sdo9/talking-multimeter/board-pics/bottom.JPG

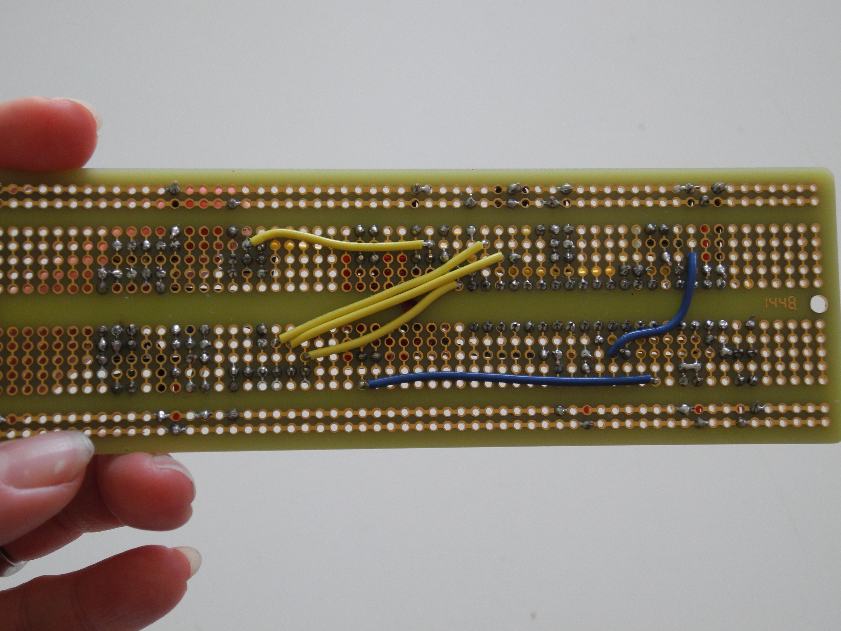
board-pics/bottom.JPG
