sdo9/talking-multimeter/board-pics/top.JPG

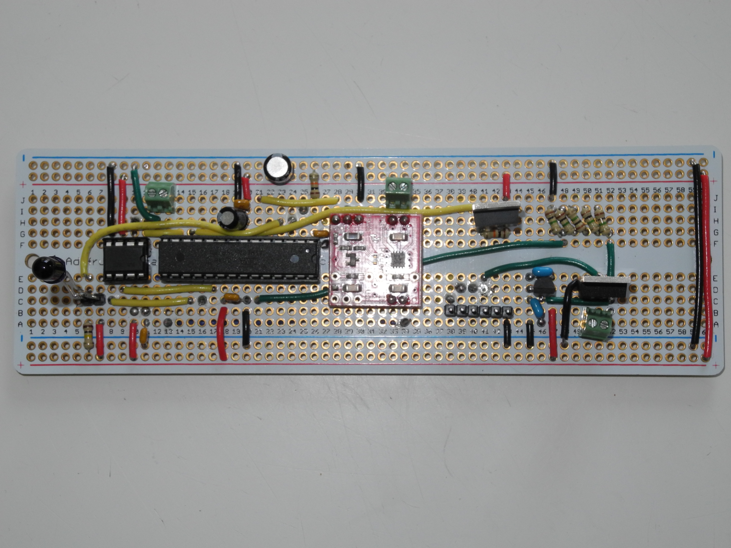
board-pics/top.JPG
