sdo9/talking-multimeter/words-flash-writer/flash-writer-arduino-sketch/sketch.ino

/*
 * Copyright 2014-2016 by Stéphane Doyon <steph@electrons.space>
 *
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
 * Winbond SPI flash loader. Simplistic.
 */

#define FLASH_CS_PIN 7

#include <Adafruit_TinyFlash.h>
#include <SPI.h>

Adafruit_TinyFlash flash(FLASH_CS_PIN);

void error(char *msg)
{
  Serial.print(F("e"));
  Serial.println(msg);
  while(1);
}

uint32_t capacity;

void setup() {
  Serial.begin(38400);
  Serial.println(F("flasher1"));

  pinMode(FLASH_CS_PIN, OUTPUT);
  digitalWrite(FLASH_CS_PIN, HIGH);
  capacity = flash.begin();
  if(!capacity) {
    flash.releasePowerDown();
    capacity = flash.begin();
  }
  while(!Serial.find("P")); // Wait for P command from host
  if(!capacity) {
    error("flash");
  }
  Serial.print(F("OK "));
  Serial.println(capacity);

  while(!Serial.find("ERASE")); // Wait for ERASE command from host
  if(!flash.eraseChip()) {
    error("erase");
  }
  Serial.println(F("OK"));
}

void loop()
{
  while(!Serial.find("W"));
  // 'W' followed by 3bytes for address MSB, then 256bytes data, then 1byte checksum.
  uint8_t buf[3+256+1];
  uint8_t csum = 0;
  unsigned long start_time = millis();
  for (int i = 0; i < 3+256+1; i++) {
    while (!Serial.available()) {
      if (millis() - start_time > 1000) {
        error("short");
      }
    }
    buf[i] = Serial.read();
    csum += buf[i];
  }

  if (csum != 0) {
    error("csum");
  }

  uint32_t address = (((uint32_t)buf[0] << 16) 
      | ((uint32_t)buf[1] << 8)
      | ((uint32_t)buf[2]));
  if (address+256 > capacity) {
    error("addr");
  }

  if(!flash.writePage(address, buf+3)) {
    error("write");
  }

  flash.beginRead(address);
  for (int i = 0; i<256; i++) {
    if (buf[3+i] != flash.readNextByte()) {
      error("verif");
    }
  }

  Serial.print(F("OK "));
  Serial.println(address);
}
