sdo9/talking-multimeter/(commit log)

2016-05-24 Fixes to compile with arduino-1.6.9 and using Arturo/ano.
2016-05-27 clean up PWM audio code
    The PWM counter is based on a fixed 8MHz clock. To have a PWM period
    equal to an audio sample duration, the counter must scale up to
    8MHz/samplerate. Hence:
    PWM_CLOCK = 8000000
    PWM_SCALE = PWM_CLOCK / SAMPLERATE
    Then each sample pulse must have a width proportional to the actual
    sample value. Our samples have a magnitude of 8 bits. Therefore:
    pulse_width = sample * PWM_SCALE / 2^8
    Because of bit truncation, the constant PWM_SCALE / 2^8 cannot be
    combined. Doing the multiplication first does overflow 16 bits hence the
    cast to uint32_t. And shifting the result right by 8 bits is the best way
    to divide by a power of 2.
    This allows for reducing in half the amoun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
    [sketch.ino]
2016-05-27 prefetch next audio sample
    This way the sample is ready the moment the IRQ fires. This reduces
    potential jitter that might be caused by the flash access.
    [sketch.ino]
2016-05-27 disable dithering when converting audio samples to 8 bits
    Dithering is a technique that adds random noise to those bits that are
    about to be dropped so the remaining LSB can partially represent the
    signal information that would otherwise be lost. When only 8 bits remain,
    this added noise represents -45 dB of the total signal which is
    sufficiently important to be easily heard, especially with speech.
    [make.py]
2016-05-28 Let the speech generation script decide the sampling rate.
    Have make.py specify the sampling rate through a define in words_def.h.
    Boost it from 16000 to 18000 because there's a bit of room left in the
    flash, on request from Nicolas. May need to reduce this if we ever run
    out of room.
    Have make.py warn if the output is too large.
    [make.py, sketch.ino]
2016-05-29 don't skip last audio sample
    Let's decrement the sample count only when it is consumed.
    No need to safeguard against len == 0 on the first prefetch. It was
    initially there to prevent catastrophical behavior if len ended up being
    negative. Now that we decrement it later, if the audio clip length is
    really zero then only one byte of garbage will be played.
    [sketch.ino]
2016-06-04 Makefile: add an asmdump target
    For the assembly output junkie like me. :-)
2016-06-04 soft_rx: a new software serial implementation replacing SoftwareSerial.cpp
    SoftwareSerial.cpp waits for each data bits within an interrupt handler,
    using busy loops to take care of timing. This means IRQs are off during
    the whole period and the system is free to do other things only during
    the duration of the stop bit. In other words, within a burst of serial
    reception, the CPU is busy spinning 90% of the time with IRQs disabled.
    This soft_rx implementation is completely interrupt driven with no busy
    waits wasting precious CPU cycles anywhere. The IRQ handler does only
    the minimum to record signal transition timing and leaves the IRQs
    enabled for other timing sensitive tasks such as audio p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
2016-06-04 make the audio ISR interruptable
    We do ADPCM in the audio ISR. That's fine if we don't want the audio
    to underrun. However time critical ISRs such as the soft_rx one must
    be serviceable even during ADPCM decode.
2016-06-07 soft_rx: simplified the code flow a bit
2016-06-08 be consistent with milliseconds signedness
    Let's use unsigned long throughout which is what millis() returns.
    Also remove a redundant call to millis() in handle() saving another
    26 bytes of code.
2016-06-09 Try harder to interrupt ourselves when the user twiddles the controls.
    Previously, we would interrupt ourselves on a major function change
    (dial change) by comparing the current function name to the previous
    one. However as Nicolas points out, the two voltage and 3 current dial
    positions only change the scale, and so we don't react immediately. So
    we'll detect those cases and interrupt, hoping as I think is the case
    that in those positions, scale changes happen only by user
    intervention. (This wouldn't be true for resistance or capacitance.)
    Furthermore, button presses pretty much correspond to some of the
    options flipping, in particular AC vs DC, so we now interrupt in those
    cases too.
    [es519xx.c]
2016-06-09 Turn speaking of packet receive errors back on..
    Now that Nicolas has made reception perfect...
    [sketch.ino]
2016-06-09 add a missing flash.endRead()
    It can't hurt to be consistent even if things apparently worked without it.
    [sketch.ino]
2016-06-09 don't split verbose/terse and mode
    This makes possible translations more difficult. And using playSync()
    back to back creates glitchy audio because of the momentary amp power
    drop in the middle. I don't think this is worth fixing other than trying
    to avoid it.
    [sketch.ino]
2016-06-09 make battery reporting a little more natural with a pause
2016-06-09 make sure nextSample is updated at the end
    We failed to set nextSample when playLen just reached 0.
    [sketch.ino]
2016-06-09 don't fiddle with PWM regs needlessly
2016-06-09 optimize audio quality some more
    - Let's have espeak produce full scale audio upfront rather than guessing
    a gain factor with sox.
    - Always disable dithering. There is no advantage with synthetic speech.
    This could even make things worse in some circumstances.
    - Let sox manage the reclaimable headroom to avoid possible clipping.
    - Lower the samplerate back to 16000Hz. The compromize here is bit depth
    vs frequency response. Better use sample definition with an extra
    fraction of a bit than having the ability to emit high-frequency
    quantisation noise.
    - Amend: make the samplerate back to 18000Hz. At 16000Hz there is
    some audible high frequency aliasing that gets annoying.
    For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
    [make.py]
2016-06-09 Small clarification/simplification for terse mode code.
    Reformulate a bit the code around conditional value rounding in terse vs
    verbose mode. No we didn't really need two quantize() calls.
    [es519xx.c]
2016-06-10 more audio ISR reliability changes
    Some underruns still happen from time to time creating audible glitches.
    Let's mitigate this by:
    1- Performing the PWM scaling multiplication in advance just like
    ADPCM decoding;
    2- Keeping track of missed interrupts and executing the ISR again right
    away when they occur to keep the audio in sync as much as possible.
    With those changes I don't hear the occasional glitch anymore.
    [sketch.ino]
2016-06-13 Rewrite the part that speaks options and clarify function identification.
    Identify functions by code so we know when the dial changed between the
    three current positions, without having to look at their scale.
    Add pseudo function codes for the voltage case where we still need to look
    at the scale to tell the two dial positions apart. This should at least be
    more readable.
    Also pseudo function codes for Frequency and duty cycle.
    Rethink how options are spoken: we used to have a priority logic such that
    if we spoke one option, then we would speak all following ones. Now that I
    have a better sense for the possible transitions, This no longer seems
    justified, so we no longer do that.
    Analyzing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
    [es519xx.c]
2016-06-13 make language selection possible from the command line
    The LANG variable is renamed to LANGUAGE otherwise make will pick
    the content from the environment which in my case is currently
    LANG=en_US.UTF-8.
2016-06-13 work around some sox v14.4.1 issue
    It seems that sox v14.4.1 adds artifacts when resampling a file with
    no signal. Generate some silence with the right samplerate upfront.
    [make.py]
2016-06-13 Documentation updates
    - Add documentation for word list and language support.
    - Remove obsolete info about SoftwareSerial.
    - Move rationale for input pin selection to circuit-spec.txt as it
    doesn't look like it belong in the README file anymore. This made
    the DMM section rather thin so it is now gone.
    - Minor text layout adjustments.
2016-08-26 Couple README clarifications.
    Added brief thanks and list if Nico's major contributions.
    Minor precisions and fixes.
